BigBroBob2/bat_tag_nrf5340dk/Kicad/Chenhao_library/ICM-42688-P/ICM-42688-P.step

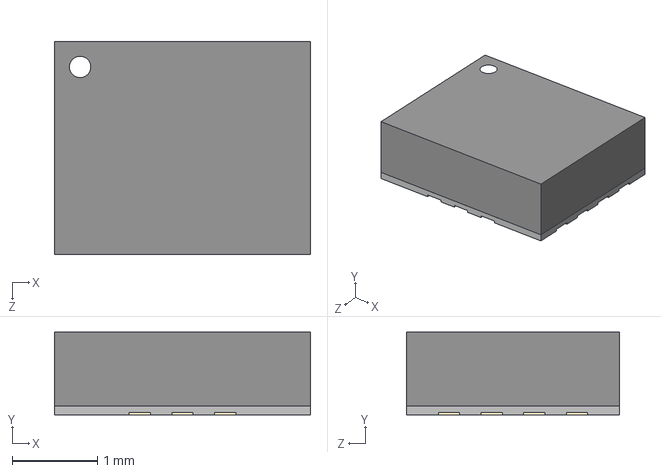
[picture p1: CAD file, 2023-09-20]
Kicad/Chenhao_library/ICM-42688-P/ICM-42688-P.step
3.00 x 0.97 x 2.50 mm
