BigBroBob2/bat_tag_nrf5340dk/Kicad/Chenhao_library/MEM2075-00-140-01-A/MEM2075-00-140-01-A.step

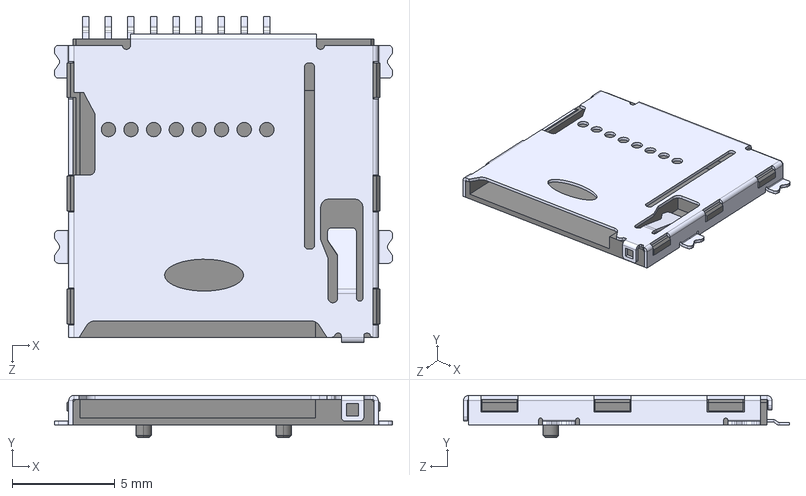
[picture p2: CAD file, 2023-09-20]
Kicad/Chenhao_library/MEM2075-00-140-01-A/MEM2075-00-140-01-A.step
16.4 x 2.05 x 15.9 mm
