BigBroBob2/bat_tag_nrf5340dk/Kicad/Chenhao_library/SPH0655LM4H-1/SPH0655LM4H-1.step

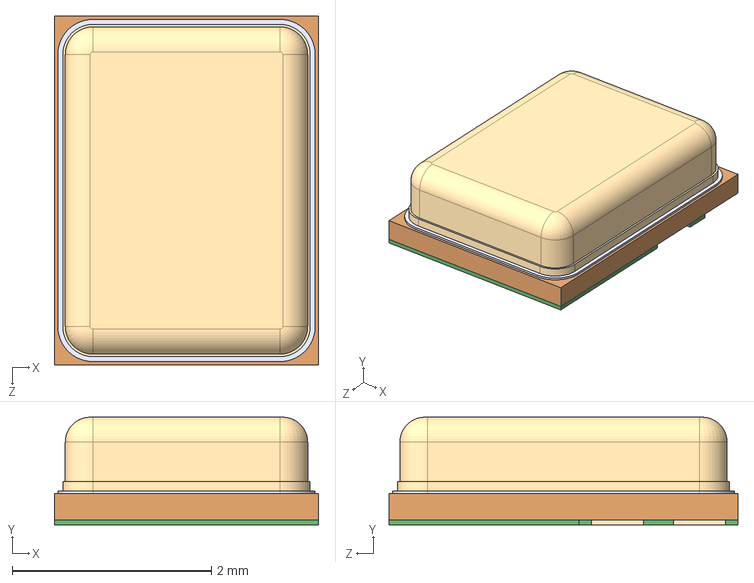
[picture p3: CAD file, 2023-09-20]
Kicad/Chenhao_library/SPH0655LM4H-1/SPH0655LM4H-1.step
2.65 x 1.08 x 3.50 mm
