BigBroBob2/bat_tag_nrf5340dk/Kicad/mainboard_v2/Bat_double_IMU_SPI.pdf

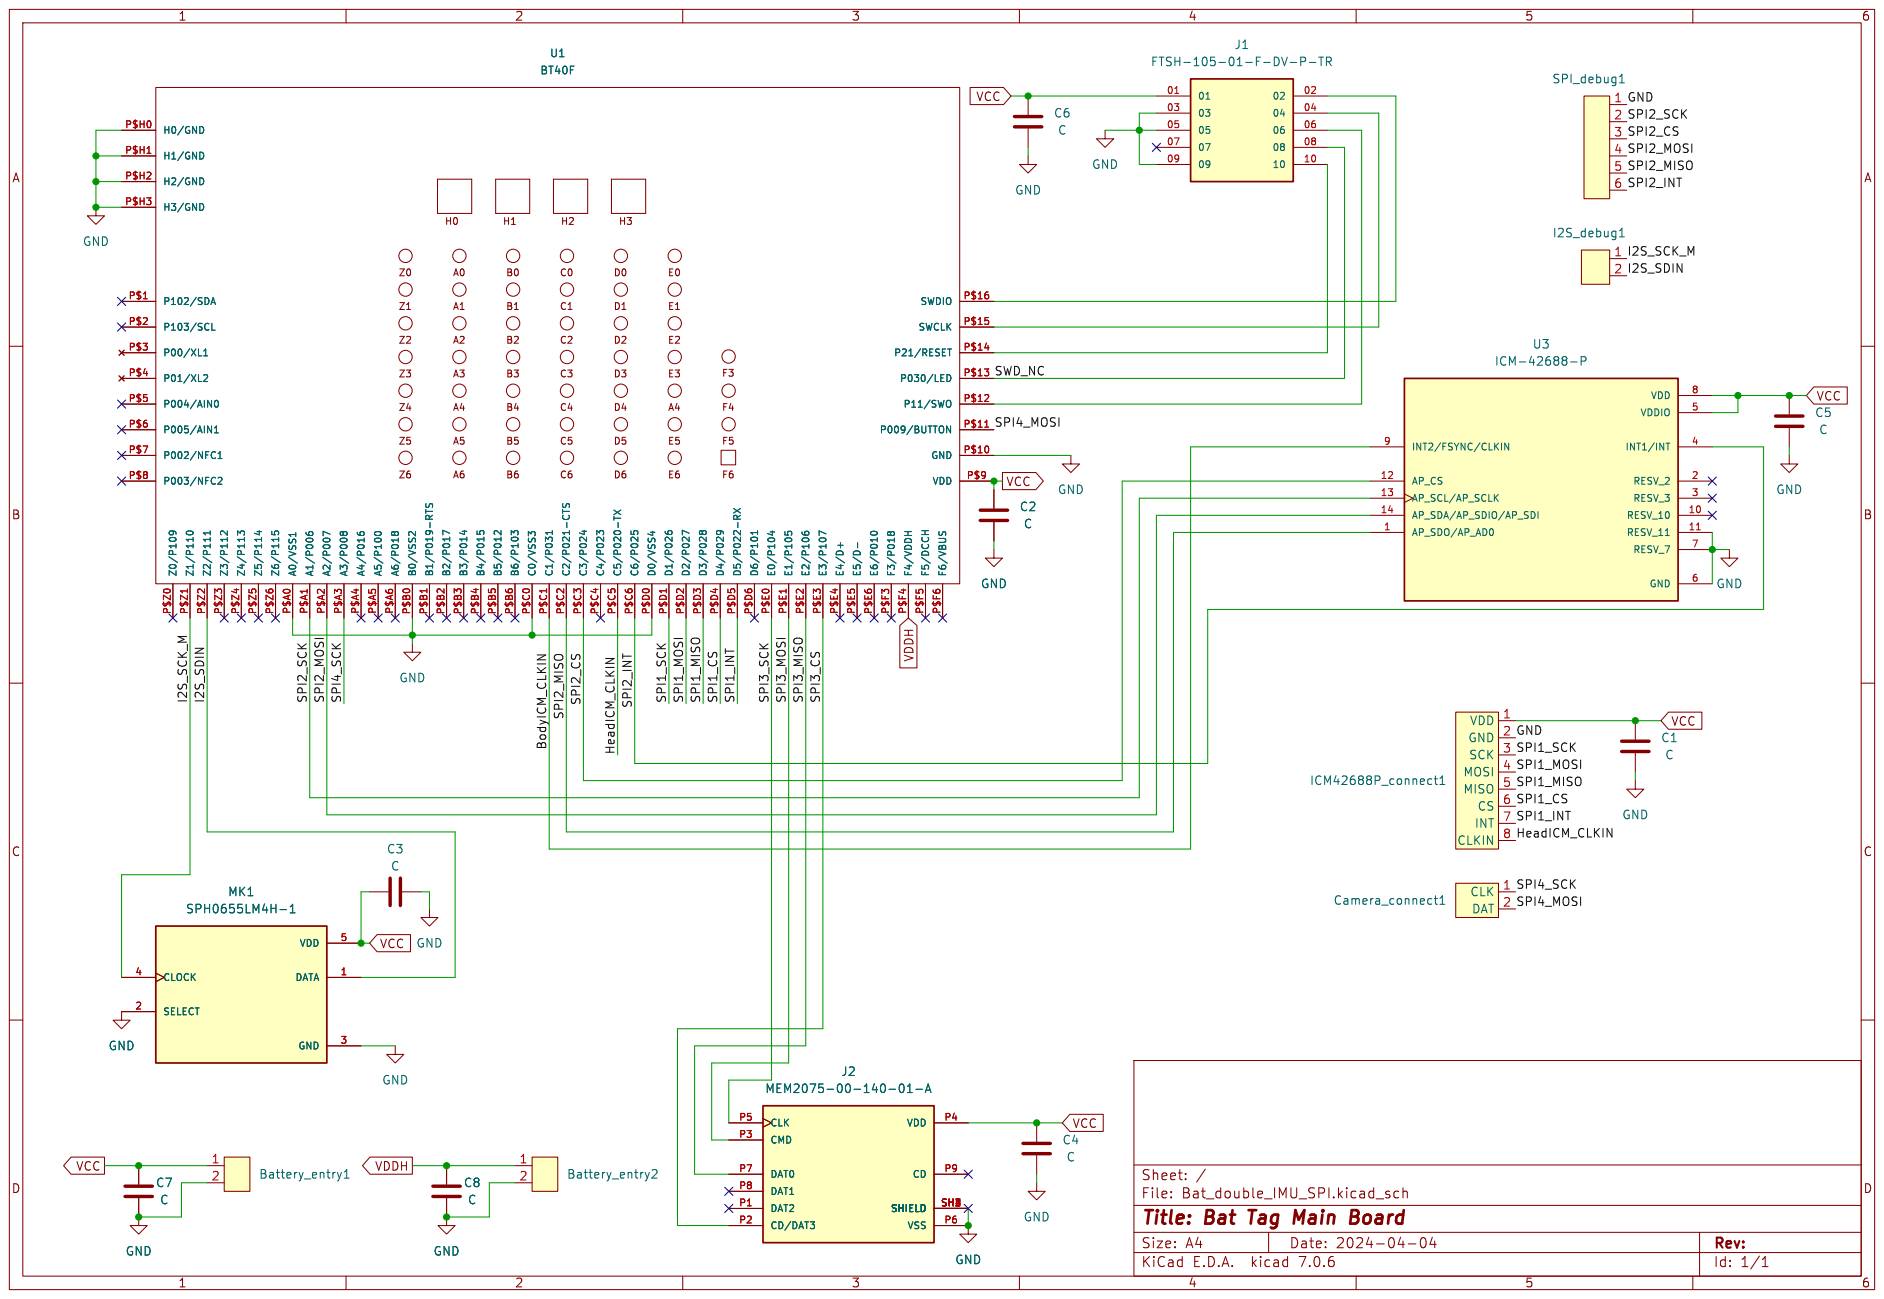
[picture p4: page 1]

VDD 1 GND 2 SCK 3 MOSI 4 MISO 5 CS 6

Id: 1/1 Title: Bat Tag Main Board
