BigBroBob2/bat_tag_nrf5340dk/Kicad/headboard/headboard.kicad_pcb

## KiCad design Kicad/headboard/headboard.kicad_pcb (2024-08-05)

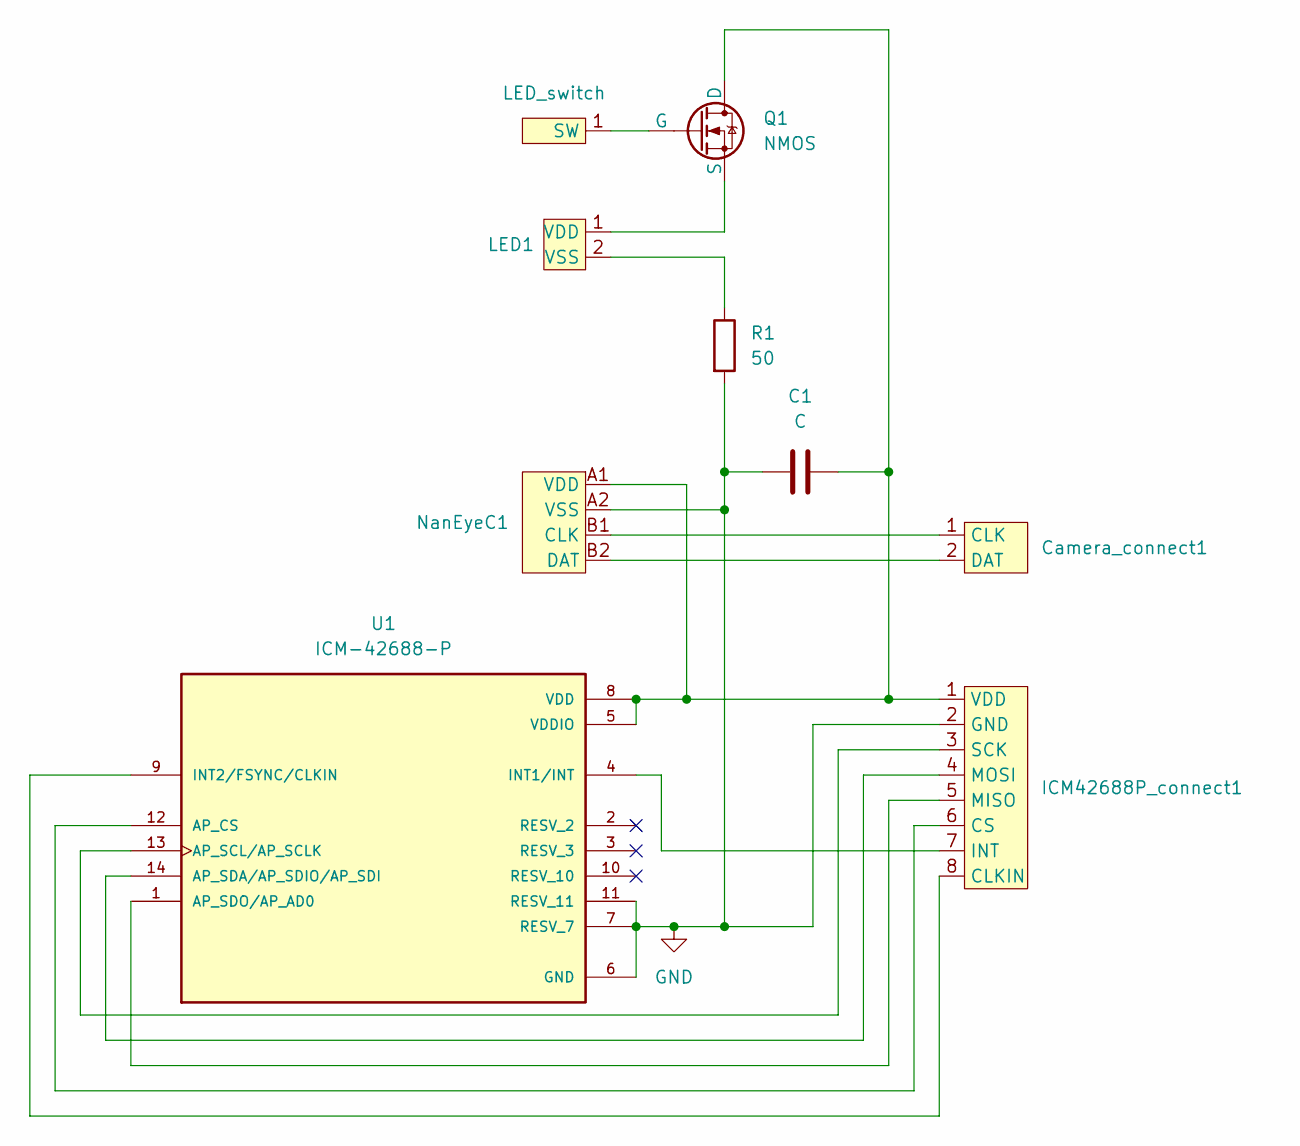
[picture p5: schematic headboard.kicad_sch]

Parts:
C1: C; C_0603_1608Metric
Camera_connect1: camera_connect
Camera_connect2: LED_switch
ICM42688P_connect1: ICM42688P_connect
LED1: LED_1206_3216Metric
NanEyeC1: NanEyeC
Q1: NMOS; SOT-23
R1: 50; R_0603_1608Metric
U1: ICM-42688-P; PQFN50P300X250X97-14N; PARTREV 1.2

Connections:
GND: C1.1, ICM42688P_connect1.2 (GND), NanEyeC1.A2 (VSS), R1.2, U1.6 (GND), U1.7 (RESV_7), U1.11 (RESV_11)
unnamed: Camera_connect1.1 (CLK), NanEyeC1.B1 (CLK)
unnamed: Camera_connect1.2 (DAT), NanEyeC1.B2 (DAT)
unnamed: Camera_connect2.1 (SW), Q1.2 (G)
unnamed: ICM42688P_connect1.8 (CLKIN), U1.9 (INT2/FSYNC/CLKIN)
unnamed: ICM42688P_connect1.6 (CS), U1.12 (AP_CS)
unnamed: ICM42688P_connect1.7 (INT), U1.4 (INT1/INT)
unnamed: ICM42688P_connect1.5 (MISO), U1.1 (AP_SDO/AP_AD0)
unnamed: ICM42688P_connect1.4 (MOSI), U1.14 (AP_SDA/AP_SDIO/AP_SDI)
unnamed: ICM42688P_connect1.3 (SCK), U1.13 (AP_SCL/AP_SCLK)
unnamed: C1.2, ICM42688P_connect1.1 (VDD), NanEyeC1.A1 (VDD), Q1.1 (D), U1.5 (VDDIO), U1.8 (VDD)
unnamed: LED1.1 (VDD), Q1.3 (S)
unnamed: LED1.2 (VSS), R1.1

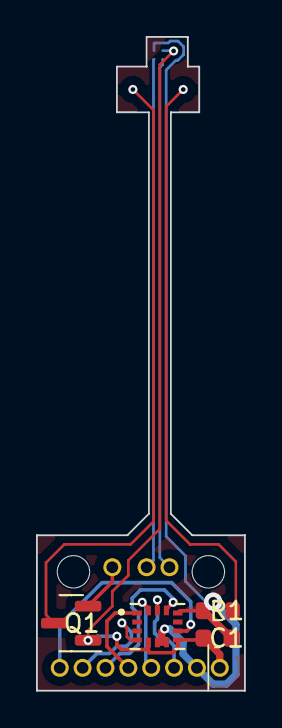
[picture p6: board headboard.kicad_pcb from above]

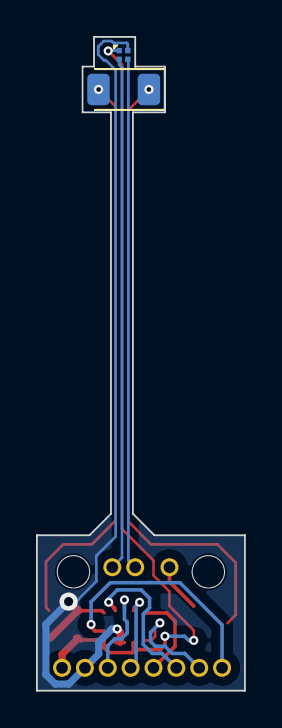
[picture p7: board headboard.kicad_pcb from below]

Board: 2 copper layers, 11.6 x 36.3 mm, 9 parts (2 on the bottom side), 13 nets.
