BigBroBob2/bat_tag_nrf5340dk/Kicad/mainboard_v1/Bat_IMU_nRF5340.kicad_pcb

## KiCad design Kicad/mainboard_v1/Bat_IMU_nRF5340.kicad_pcb (2023-10-03, an earlier design)

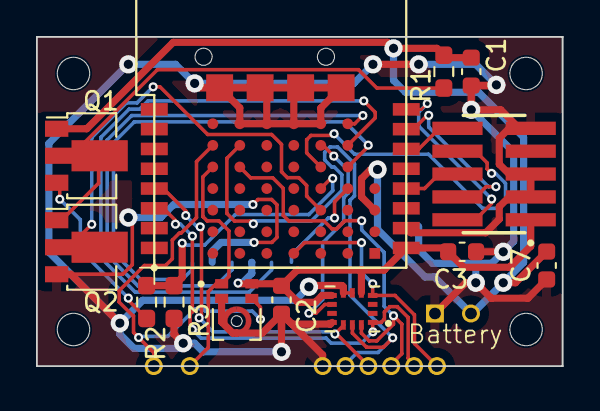
[picture p8: board Bat_IMU_nRF5340.kicad_pcb from above]

Board: 2 copper layers, 29.2 x 18.3 mm, 17 parts (1 on the bottom side), 24 nets.

Parts:
Battery: Battery_entry
C1, C2, C3, C7: C; C_0603_1608Metric
I2S_debug1: I2S_debug
J1: FTSH-105-01-F-DV-P-TR; SAMTEC_FTSH-105-01-F-DV-P-TR
J2: MEM2075-00-140-01-A; GCT_MEM2075-00-140-01-A
MK1: SPH0655LM4H-1; MIC_SPH0655LM4H-1
Q1: PMOS; SOT-89-3
Q2: NMOS; SOT-89-3
R1: 100k; R_0603_1608Metric_Pad0.98x0.95mm_HandSolder
R2, R3: R; R_0603_1608Metric_Pad0.98x0.95mm_HandSolder
SPI_debug1: SPI_debug
U1: BT40F
U3: ICM-42688-P; PQFN50P300X250X97-14N

Connections:
/I2S_SCK_M: I2S_debug1.1, MK1.4 (CLOCK), U1.P$Z1 (Z1/P110)
/I2S_SDIN: I2S_debug1.2, MK1.1 (DATA), U1.P$Z2 (Z2/P111)
/ICM_CLKIN: U1.P$D1 (D1/P026), U3.9 (INT2/FSYNC/CLKIN)
/SPI2_CS: SPI_debug1.3, U1.P$5 (P004/AIN0), U3.12 (AP_CS)
/SPI2_INT: SPI_debug1.6, U1.P$C6 (C6/P025), U3.4 (INT1/INT)
/SPI2_MISO: SPI_debug1.5, U1.P$6 (P005/AIN1), U3.1 (AP_SDO/AP_AD0)
/SPI2_MOSI: SPI_debug1.4, U1.P$A2 (A2/P007), U3.14 (AP_SDA/AP_SDIO/AP_SDI)
/SPI2_SCK: SPI_debug1.2, U1.P$A1 (A1/P006), U3.13 (AP_SCL/AP_SCLK)
/SPI3_CS: J2.P2 (CD/DAT3), U1.P$E3 (E3/P107)
/SPI3_MISO: J2.P7 (DAT0), U1.P$E2 (E2/P106)
/SPI3_MOSI: J2.P3 (CMD), U1.P$E1 (E1/P105)
/SPI3_SCK: J2.P5 (CLK), U1.P$E0 (E0/P104)
/SWD_NC: J1.08, U1.P$D2 (D2/P027)
GND: Battery.2, C1.1, C2.1, C3.1, C7.1, J1.03, J1.05, J1.09, J2.P6 (VSS), J2.SH1 (SHIELD), J2.SH2 (SHIELD), J2.SH3 (SHIELD), J2.SH4 (SHIELD), MK1.2 (SELECT), MK1.3 (GND), Q2.3 (S), R3.2, SPI_debug1.1, U1.P$10 (GND), U1.P$A0 (A0/VSS1), U1.P$B0 (B0/VSS2), U1.P$C0 (C0/VSS3), U1.P$D0 (D0/VSS4), U1.P$H0 (H0/GND), U1.P$H1 (H1/GND), U1.P$H2 (H2/GND), U1.P$H3 (H3/GND), U3.6 (GND), U3.7 (RESV_7), U3.11 (RESV_11)
unnamed: Q1.2 (G), Q2.1 (D), R1.1
unnamed: Q1.3 (S), R2.1
unnamed: Q2.2 (G), U1.P$D4 (D4/P029)
unnamed: J1.06, U1.P$12 (P11/SWO)
unnamed: J1.10, U1.P$14 (P21/RESET)
unnamed: J1.04, U1.P$15 (SWCLK)
unnamed: J1.02, U1.P$16 (SWDIO)
VBAT: Battery.1, C1.2, C7.2, Q1.1 (D), R1.2, U1.P$F4 (F4/VDDH)
VBAT_div: R2.2, R3.1, U1.P$D3 (D3/P028)
VCC: C2.2, C3.2, J1.01, J2.P4 (VDD), MK1.5 (VDD), U1.P$9 (VDD), U3.5 (VDDIO), U3.8 (VDD)
