BigBroBob2/bat_tag_nrf5340dk/BT40_v2_current_code/src/SDcard.h

/*SDcard*/

#ifndef SDCARD_H
#define SDCARD_H 1
#endif

#include <stdio.h>
#include <string.h>
#include <stdlib.h>
#include <zephyr/device.h>
#include <zephyr/storage/disk_access.h>
#include <zephyr/kernel.h>
#include <zephyr/logging/log.h>
#include <zephyr/usb/usb_device.h>
#include <zephyr/usb/usbd.h>
#include <zephyr/usb/class/usbd_msc.h>
#include <zephyr/fs/fs.h>
#include <stdio.h>

// we use FATfs with SD card
#if CONFIG_FAT_FILESYSTEM_ELM
#include <ff.h>
#endif

#define DISK_DRIVE_NAME "SD"
#define DISK_MOUNT_PT "/"DISK_DRIVE_NAME":"
char file_name[16];
static const char *disk_mount_pt = DISK_MOUNT_PT;

static FATFS fat_fs;
static struct fs_mount_t mp = {
	.type = FS_FATFS,
	.fs_data = &fat_fs,
};

static struct fs_mount_t fs_mnt;

static int mount_app_fs(struct fs_mount_t *mnt)
{
	int rc;

	mnt->type = FS_FATFS;
	mnt->fs_data = &fat_fs;

	if (IS_ENABLED(CONFIG_DISK_DRIVER_SDMMC)) {
		mnt->mnt_point = "/SD:";
	} else {
		mnt->mnt_point = "/NAND:";
	}

	rc = fs_mount(mnt);

	return rc;
}

static void setup_disk(void)
{
	struct fs_mount_t *mp = &fs_mnt;
	struct fs_dir_t dir;
	struct fs_statvfs sbuf;
	int rc;

	fs_dir_t_init(&dir);

		if (!IS_ENABLED(CONFIG_FILE_SYSTEM_LITTLEFS) &&
	    !IS_ENABLED(CONFIG_FAT_FILESYSTEM_ELM)) {
		printk("No file system selected\n");
		return;
	}

	rc = mount_app_fs(mp);
	if (rc < 0) {
		printk("Failed to mount filesystem\n");
		return;
	}

	/* Allow log messages to flush to avoid interleaved output */
	k_sleep(K_MSEC(50));

	printk("Mount %s: %d\n", fs_mnt.mnt_point, rc);

	rc = fs_statvfs(mp->mnt_point, &sbuf);
	if (rc < 0) {
		printk("FAIL: statvfs: %d\n", rc);
		return;
	}

	printk("%s: bsize = %lu ; frsize = %lu ;"
	       " blocks = %lu ; bfree = %lu\n",
	       mp->mnt_point,
	       sbuf.f_bsize, sbuf.f_frsize,
	       sbuf.f_blocks, sbuf.f_bfree);

	rc = fs_opendir(&dir, mp->mnt_point);
	printk("%s opendir: %d\n", mp->mnt_point, rc);

	if (rc < 0) {
		printk("Failed to open directory\n");
	}

	while (rc >= 0) {
		struct fs_dirent ent = { 0 };

		rc = fs_readdir(&dir, &ent);
		if (rc < 0) {
			printk("Failed to read directory entries\n");
			break;
		}
		if (ent.name[0] == 0) {
			printk("End of files\n");
			break;
		}
		printk("  %c %u %s\n",
		       (ent.type == FS_DIR_ENTRY_FILE) ? 'F' : 'D',
		       ent.size,
		       ent.name);
	}

	(void)fs_closedir(&dir);

	return;
}

/* List dir entry by path
 *
 * @param path Absolute path to list
 *
 * @return Negative errno code on error, number of listed entries on
 *         success.
 */
static int lsdir(const char *path)
{
	int res;
	struct fs_dir_t dirp;
	static struct fs_dirent entry;
	int count = 0;

	fs_dir_t_init(&dirp);

	/* Verify fs_opendir() */
	res = fs_opendir(&dirp, path);
	if (res) {
		printk("Error opening dir %s [%d]\n", path, res);
		return res;
	}

	printk("\nListing dir %s ...\n", path);
	for (;;) {
		/* Verify fs_readdir() */
		res = fs_readdir(&dirp, &entry);

		/* entry.name[0] == 0 means end-of-dir */
		if (res || entry.name[0] == 0) {
			break;
		}

		if (entry.type == FS_DIR_ENTRY_DIR) {
			printk("[DIR ] %s\n", entry.name);
		} else {
			printk("[FILE] %s (size = %zu)\n",
				entry.name, entry.size);
		}
		count++;
	}

	/* Verify fs_closedir() */
	fs_closedir(&dirp);
	if (res == 0) {
		res = count;
	}

	return res;
}
