BigBroBob2/bat_tag_nrf5340dk/(commit log)

2023-08-23 spi interface for ICM42688, interrupt to read mic
2023-08-23 now can sample IMU and mic data together
2023-08-24 now can disable i2s thread and ICM thread
2023-08-30 Now can record time and IMU buf len
2023-09-01 add 1kHz ICM Interrupt
2023-09-06 Now use ICM_IRQ to sample IMU data
2023-09-11 use circular buffer for IMU recording
2023-09-17 IMU sample data dropout fixed
    [main.c]
2023-09-20 Add Kicad project, First version schematic
    [Bat_IMU_nRF5340.kicad_pcb, Bat_IMU_nRF5340.kicad_sch, Fanstel-kicad-library.kicad_pcb, Fanstel-kicad-library.sch, ICM-42688-P.step, MEM2075-00-140-01-A.step, SPH0655LM4H-1.step]
2023-09-25 Kicad first version layout update
    [Bat_IMU_nRF5340.kicad_pcb, Bat_IMU_nRF5340.kicad_sch]
2023-10-03 Kicad PCB update
    [Bat_IMU_nRF5340.kicad_pcb, Bat_IMU_nRF5340.kicad_sch]
2023-11-01 BT40 working, I2S LRCK_M and SDIN pins switched
2023-11-29 Add 2nd IMU SPI, multi-trial cir-buf out range
2023-12-01 multi-trial cir-buf outrange fixed,need enable SPI
    [circular_buffer.h, main.c]
2023-12-01 IMU_data[9], save 6D data and time and idx
2024-01-29 add NanEyeC camera, not tested
2024-02-02 Add camera thread
2024-02-08 thread-time-working version with camera
2024-02-08 20 fps camera with ROI and no threshold
2024-03-08 fixed VDDH high vol mode, improved trial_count when reset
    [NanEyeC.h, main.c]
2024-03-18 add real time camera 4*4 avg downsample
2024-03-20 add different camera zoom_mode
2024-03-21 add timestamp to camera frame and audio block
2024-03-22 add imu and cam enable/disable, and cam_fs bt command
2024-04-01 move camera init inside trial loop, which fixed camera 1st frame
    [main.c]
2024-04-03 init camera circular buf read and write index before every trial
2024-04-08 update PCB and code for v2
    [Bat_IMU_nRF5340.kicad_pcb, Bat_IMU_nRF5340.kicad_sch, Bat_double_IMU_SPI.kicad_pcb, Bat_double_IMU_SPI.kicad_sch]
2024-08-05 upload headboard flex pcb
    [headboard.kicad_pcb, headboard.kicad_sch]
